dadebertolino/stazione-meteo-lora/hardware/nodo-bme280/nodo-bme280-bom-jlcpcb.csv

Comment | Designator | Footprint | LCSC Part #
10µF 25V X5R 0805 | C1 | C_0805_2012Metric_Pad1.18x1.45mm_HandSolder | C15850
100nF 50V X7R 0805 | C2,C3 | C_0805_2012Metric_Pad1.18x1.45mm_HandSolder | C49678
DMG2305UX-7 | Q1 | SOT-23_Handsoldering | C150470
10k 1% 0805 | R1,R2 | R_0805_2012Metric_Pad1.20x1.40mm_HandSolder | C17414
