dadebertolino/stazione-meteo-lora/hardware/ricevitore/ricevitore-bom-jlcpcb.csv

Comment | Designator | Footprint | LCSC Part #
1µF 50V X7R 0805 | C1 | C_0805_2012Metric_Pad1.18x1.45mm_HandSolder | C28323
10µF 25V X5R 0805 | C2 | C_0805_2012Metric_Pad1.18x1.45mm_HandSolder | C15850
100nF 50V X7R 0805 | C3,C4,C5 | C_0805_2012Metric_Pad1.18x1.45mm_HandSolder | C49678
LED verde 0805 KT-0805G | D1 | LED_0805_2012Metric_Pad1.15x1.40mm_HandSolder | C2297
LED giallo 0805 KT-0805Y | D2 | LED_0805_2012Metric_Pad1.15x1.40mm_HandSolder | C2296
10k 1% 0805 | R3 | R_0805_2012Metric_Pad1.20x1.40mm_HandSolder | C17414
1k 1% 0805 | R4,R5 | R_0805_2012Metric_Pad1.20x1.40mm_HandSolder | C17513
USBLC6-2SC6 | U2 | SOT-23-6 | C7519
AP2112K-3.3TRG1 | U3 | SOT-23-5 | C51118
CH340C | U4 | SOIC-16_3.9x9.9mm_P1.27mm | C84681
