dadebertolino/stazione-meteo-lora/hardware/nodo-bme280/nodo-bme280-schema.pdf

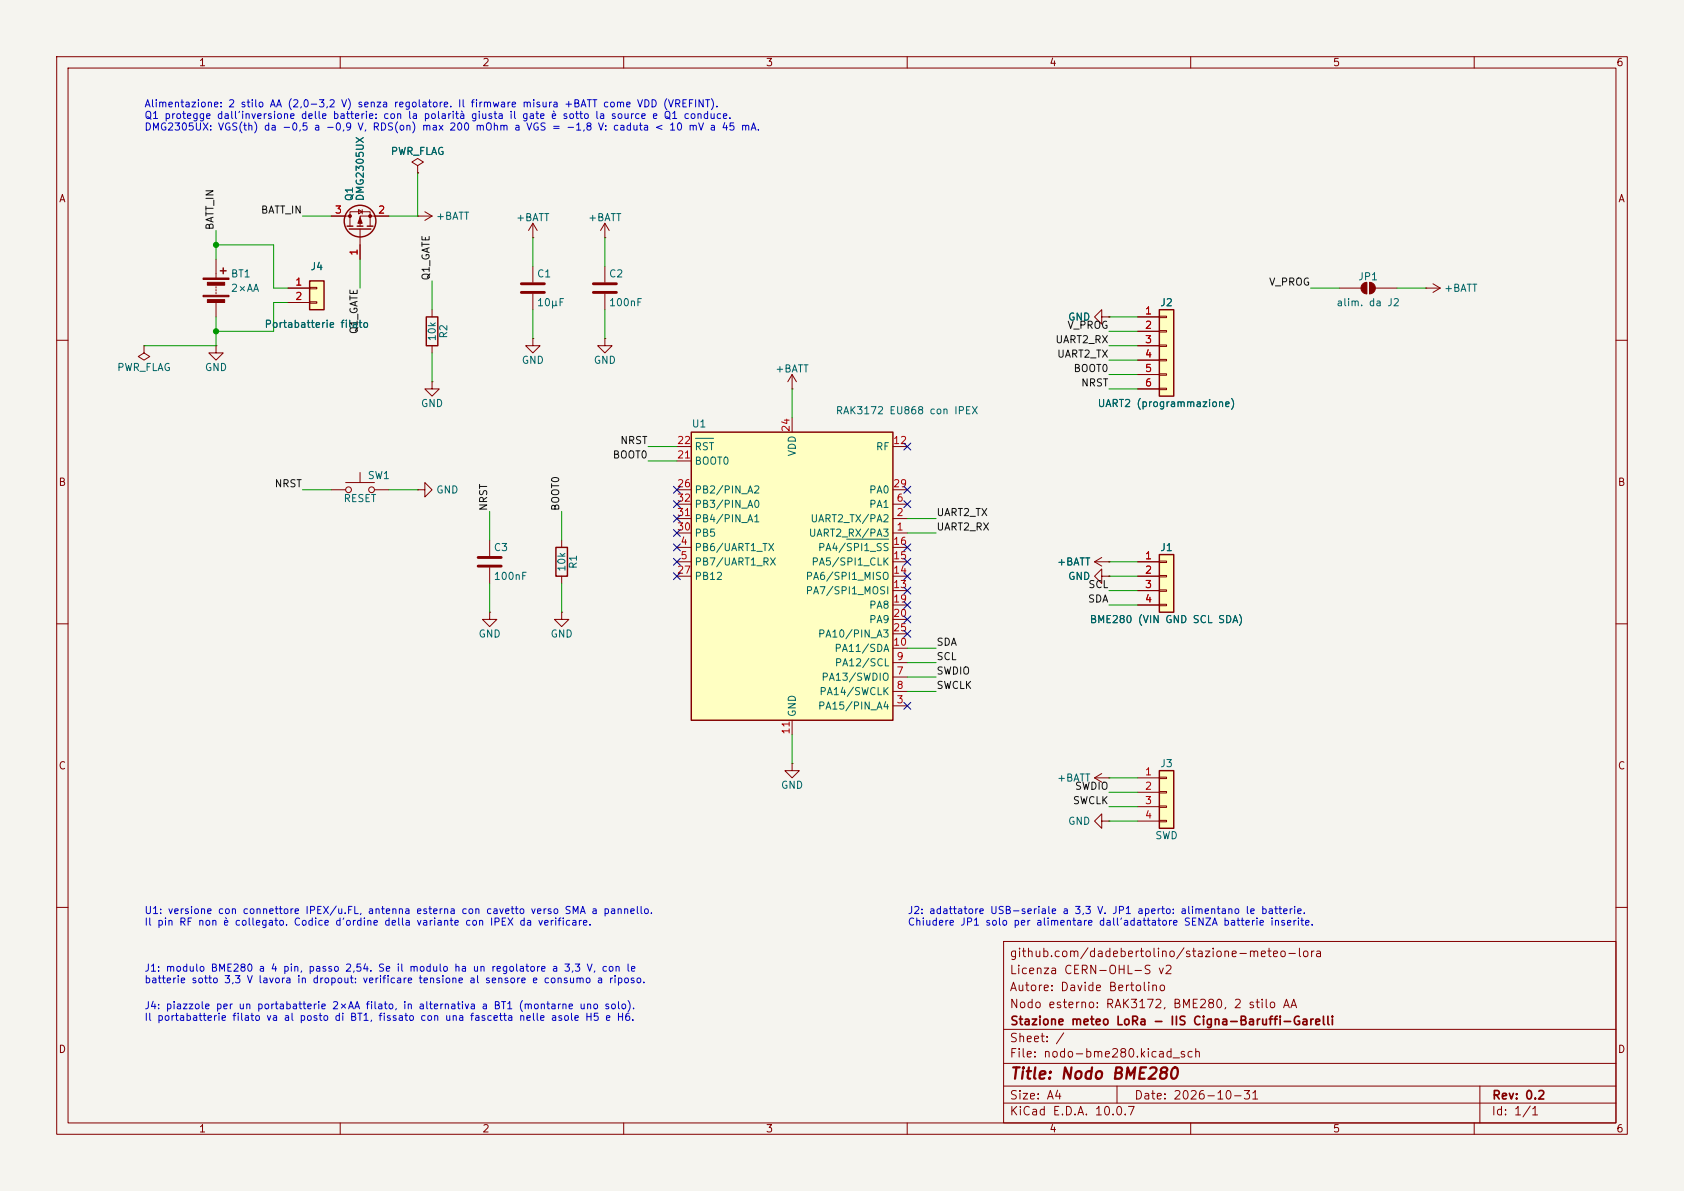
[picture p1: page 1]

Alimentazione: 2 stilo AA (2,0-3,2 V) senza regolatore. Il firmware misura +BATT come VDD (VREFINT). Q1 protegge dall'inversione delle batterie: con la polarità giusta il gate è sotto la source e Q1 conduce. DMG2305UX: VGS(th) da -0,5 a -0,9 V, RDS(on) max 200 mOhm a VGS = -1,8 V: caduta < 10 mV a 45 mA. J4 Portabatterie filato 1

J1 BME280 (VIN GND SCL SDA) +BATT C2

J1 BME280 (VIN GND SCL SDA) 1

Il portabatterie filato va al posto di BT1, fissato con una fascetta nelle asole H5 e H6. J1: modulo BME280 a 4 pin, passo 2,54. Se il modulo ha un regolatore a 3,3 V, con le batterie sotto 3,3 V lavora in dropout: verificare tensione al sensore e consumo a riposo. U1: versione con connettore IPEX/u.FL, antenna esterna con cavetto verso SMA a pannello.

github.com/dadebertolino/stazione-meteo-lora
Licenza CERN-OHL-S v2
Autore: Davide Bertolino
Nodo esterno: RAK3172, BME280, 2 stilo AA
Stazione meteo LoRa - IIS Cigna-Baruffi-Garelli
Sheet: /
File: nodo-bme280.kicad_sch
Title: Nodo BME280

J4: piazzole per un portabatterie 2×AA filato, in alternativa a BT1 (montarne uno solo).

Size: A4 | Rev: 0.2
KiCad E.D.A. 10.0.7 | Id: 1/1
