dadebertolino/stazione-meteo-lora/hardware/ricevitore/ricevitore-schema.pdf

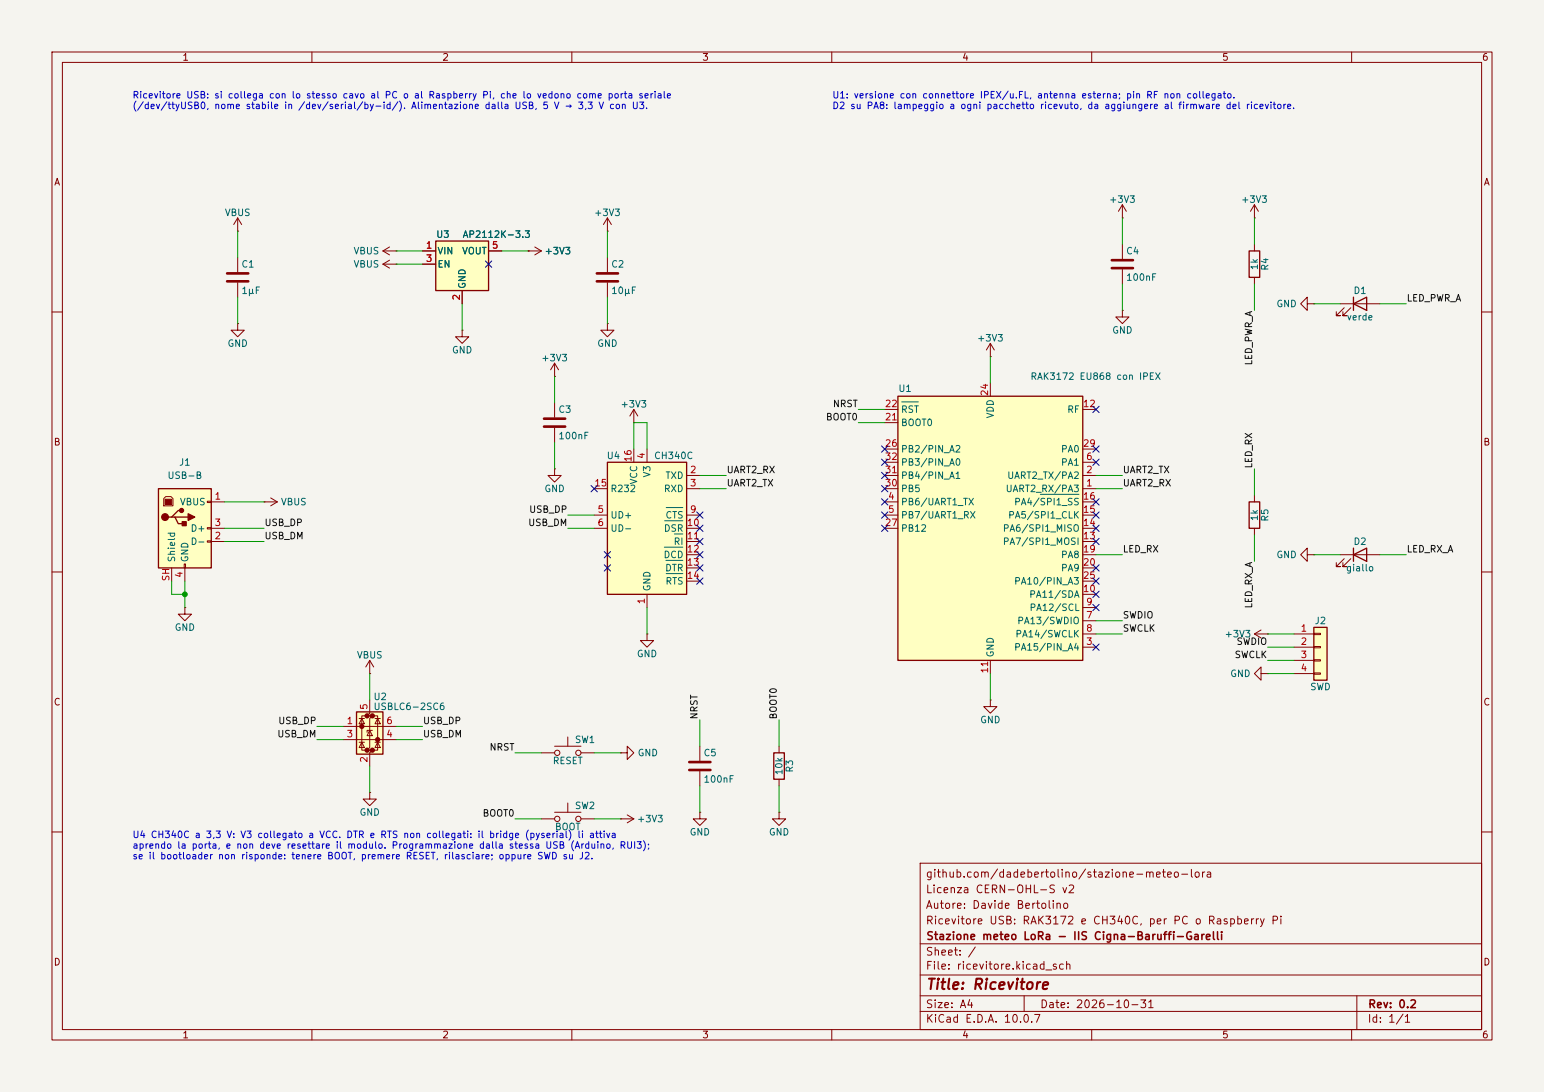
[picture p2: page 1]

Ricevitore USB: si collega con lo stesso cavo al PC o al Raspberry Pi, che lo vedono come porta seriale
(/dev/ttyUSB0, nome stabile in /dev/serial/by-id/). Alimentazione dalla USB, 5 V → 3,3 V con U3. +3V3 U3 AP2112K-3.3

U1: versione con connettore IPEX/u.FL, antenna esterna; pin RF non collegato. D2 su PA8: lampeggio a ogni pacchetto ricevuto, da aggiungere al firmware del ricevitore.

4 UD+ 5 UD- 6 CTS 9 DSR 10 RI 11 DCD 12 DTR 13 RTS 14 R232 15 VCC U4 16CH340C

U4 CH340C a 3,3 V: V3 collegato a VCC. DTR e RTS non collegati: il bridge (pyserial) li attiva
aprendo la porta, e non deve resettare il modulo. Programmazione dalla stessa USB (Arduino, RUI3); se il bootloader non risponde: tenere BOOT, premere RESET, rilasciare; oppure SWD su J2.

github.com/dadebertolino/stazione-meteo-lora
Licenza CERN-OHL-S v2
Autore: Davide Bertolino
Ricevitore USB: RAK3172 e CH340C, per PC o Raspberry Pi
Stazione meteo LoRa - IIS Cigna-Baruffi-Garelli
Sheet: /
File: ricevitore.kicad_sch
Title: Ricevitore

Size: A4 | Rev: 0.2
KiCad E.D.A. 10.0.7 | Id: 1/1
