dadebertolino/stazione-meteo-lora/hardware/nodo-bme280/nodo-bme280.kicad_pcb

## KiCad design hardware/nodo-bme280/nodo-bme280.kicad_pcb (2026-11-05)

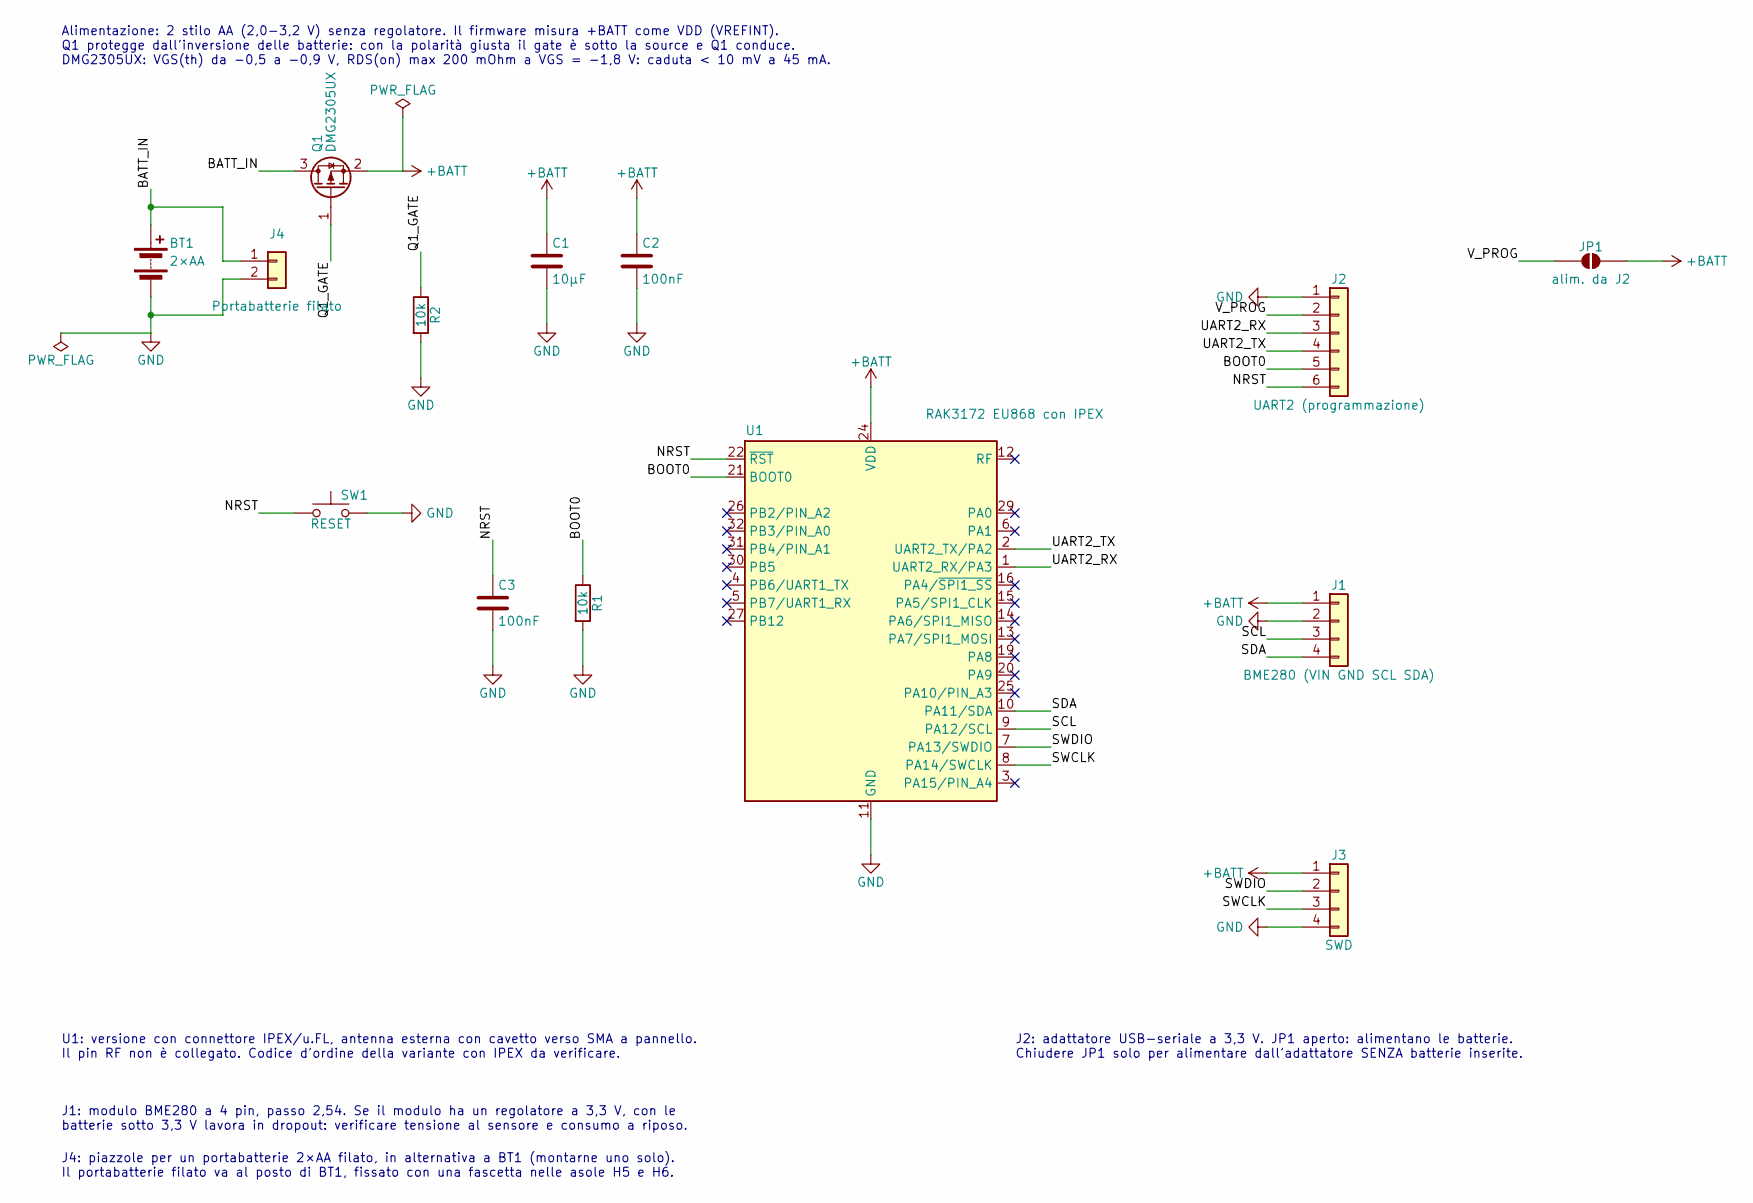
[picture p3: schematic nodo-bme280.kicad_sch, Nodo BME280]

Parts:
BT1: 2×AA; BatteryHolder_Keystone_2462_2xAA
C1: 10µF; C_0805_2012Metric_Pad1.18x1.45mm_HandSolder
C2, C3: 100nF; C_0805_2012Metric_Pad1.18x1.45mm_HandSolder
J1: BME280 (VIN GND SCL SDA); PinSocket_1x04_P2.54mm_Vertical
J2: UART2 (programmazione); PinHeader_1x06_P2.54mm_Vertical
J3: SWD; PinHeader_1x04_P2.54mm_Vertical
J4: Portabatterie filato; SolderWire-0.25sqmm_1x02_P4.2mm_D0.65mm_OD1.7mm_Relief
JP1: alim. da J2; SolderJumper-2_P1.3mm_Open_RoundedPad1.0x1.5mm
Q1: DMG2305UX; SOT-23_Handsoldering
R1, R2: 10k; R_0805_2012Metric_Pad1.20x1.40mm_HandSolder
SW1: RESET; SW_PUSH_6mm
U1: RAK3172 EU868 con IPEX; RAK3172

Connections:
+BATT: C1.1, C2.1, J1.1, J3.1, JP1.2 (B), Q1.2 (S), U1.24 (VDD)
/BATT_IN: BT1.1 (+), J4.1, Q1.3 (D)
/BOOT0: J2.5, R1.1, U1.21 (BOOT0)
/NRST: C3.1, J2.6, SW1.1, U1.22 (~RST)
/Q1_GATE: Q1.1 (G), R2.1
/SCL: J1.3, U1.9 (PA12/SCL)
/SDA: J1.4, U1.10 (PA11/SDA)
/SWCLK: J3.3, U1.8 (PA14/SWCLK)
/SWDIO: J3.2, U1.7 (PA13/SWDIO)
/UART2_RX: J2.3, U1.1 (UART2_RX/PA3)
/UART2_TX: J2.4, U1.2 (UART2_TX/PA2)
/V_PROG: J2.2, JP1.1 (A)
GND: BT1.2 (-), C1.2, C2.2, C3.2, J1.2, J2.1, J3.4, J4.2, R1.2, R2.2, SW1.2, U1.11 (GND), U1.17 (GND), U1.18 (GND), U1.23 (GND), U1.28 (GND)

Notes on the sheet:
J4: piazzole per un portabatterie 2×AA filato, in alternativa a BT1 (montarne uno solo). Il portabatterie filato va al posto di BT1, fissato con una fascetta nelle asole H5 e H6.
Alimentazione: 2 stilo AA (2,0-3,2 V) senza regolatore. Il firmware misura +BATT come VDD (VREFINT). Q1 protegge dall'inversione delle batterie: con la polarità giusta il gate è sotto la source e Q1 conduce. DMG2305UX: VGS(th) da -0,5 a -0,9 V, RDS(on) max 200 mOhm a VGS = -1,8 V: caduta < 10 mV a 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
U1: versione con connettore IPEX/u.FL, antenna esterna con cavetto verso SMA a pannello. Il pin RF non è collegato. Codice d'ordine della variante con IPEX da verificare.
J1: modulo BME280 a 4 pin, passo 2,54. Se il modulo ha un regolatore a 3,3 V, con le batterie sotto 3,3 V lavora in dropout: verificare tensione al sensore e consumo a riposo.
J2: adattatore USB-seriale a 3,3 V. JP1 aperto: alimentano le batterie. Chiudere JP1 solo per alimentare dall'adattatore SENZA batterie inserite.

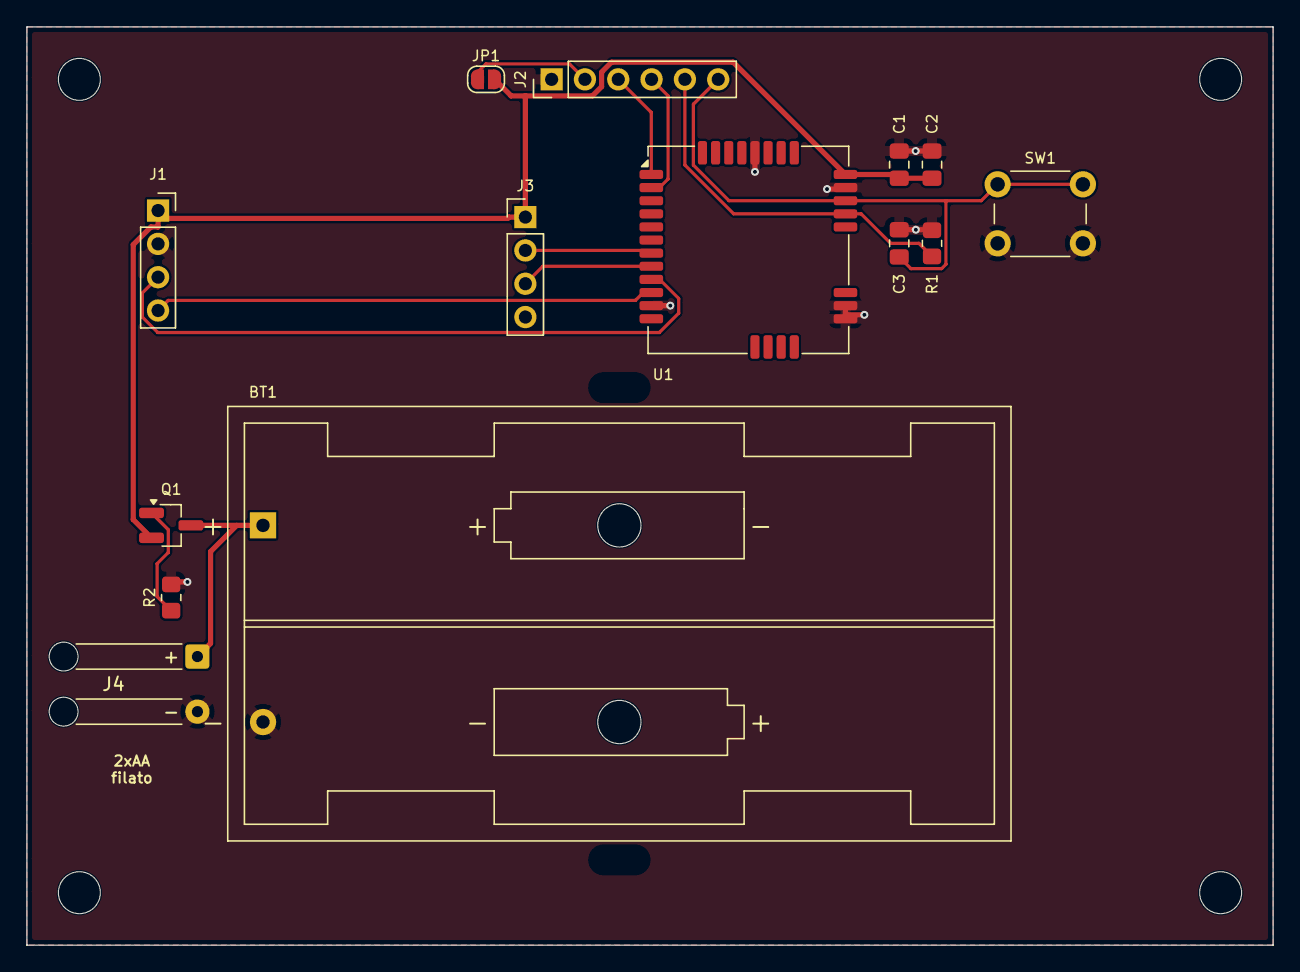
[picture p4: board nodo-bme280.kicad_pcb from above]

Board: 2 copper layers, 95.0 x 70.0 mm, 20 parts (0 on the bottom side), 13 nets.

Other parts of the board:
H1, H2, H3, H4: M3; MountingHole_3.2mm_M3
H5, H6: Asola fascetta; Asola_fascetta_4x1.6mm
