dadebertolino/stazione-meteo-lora/hardware/ricevitore/ricevitore.kicad_pcb

## KiCad design hardware/ricevitore/ricevitore.kicad_pcb (2026-11-05)

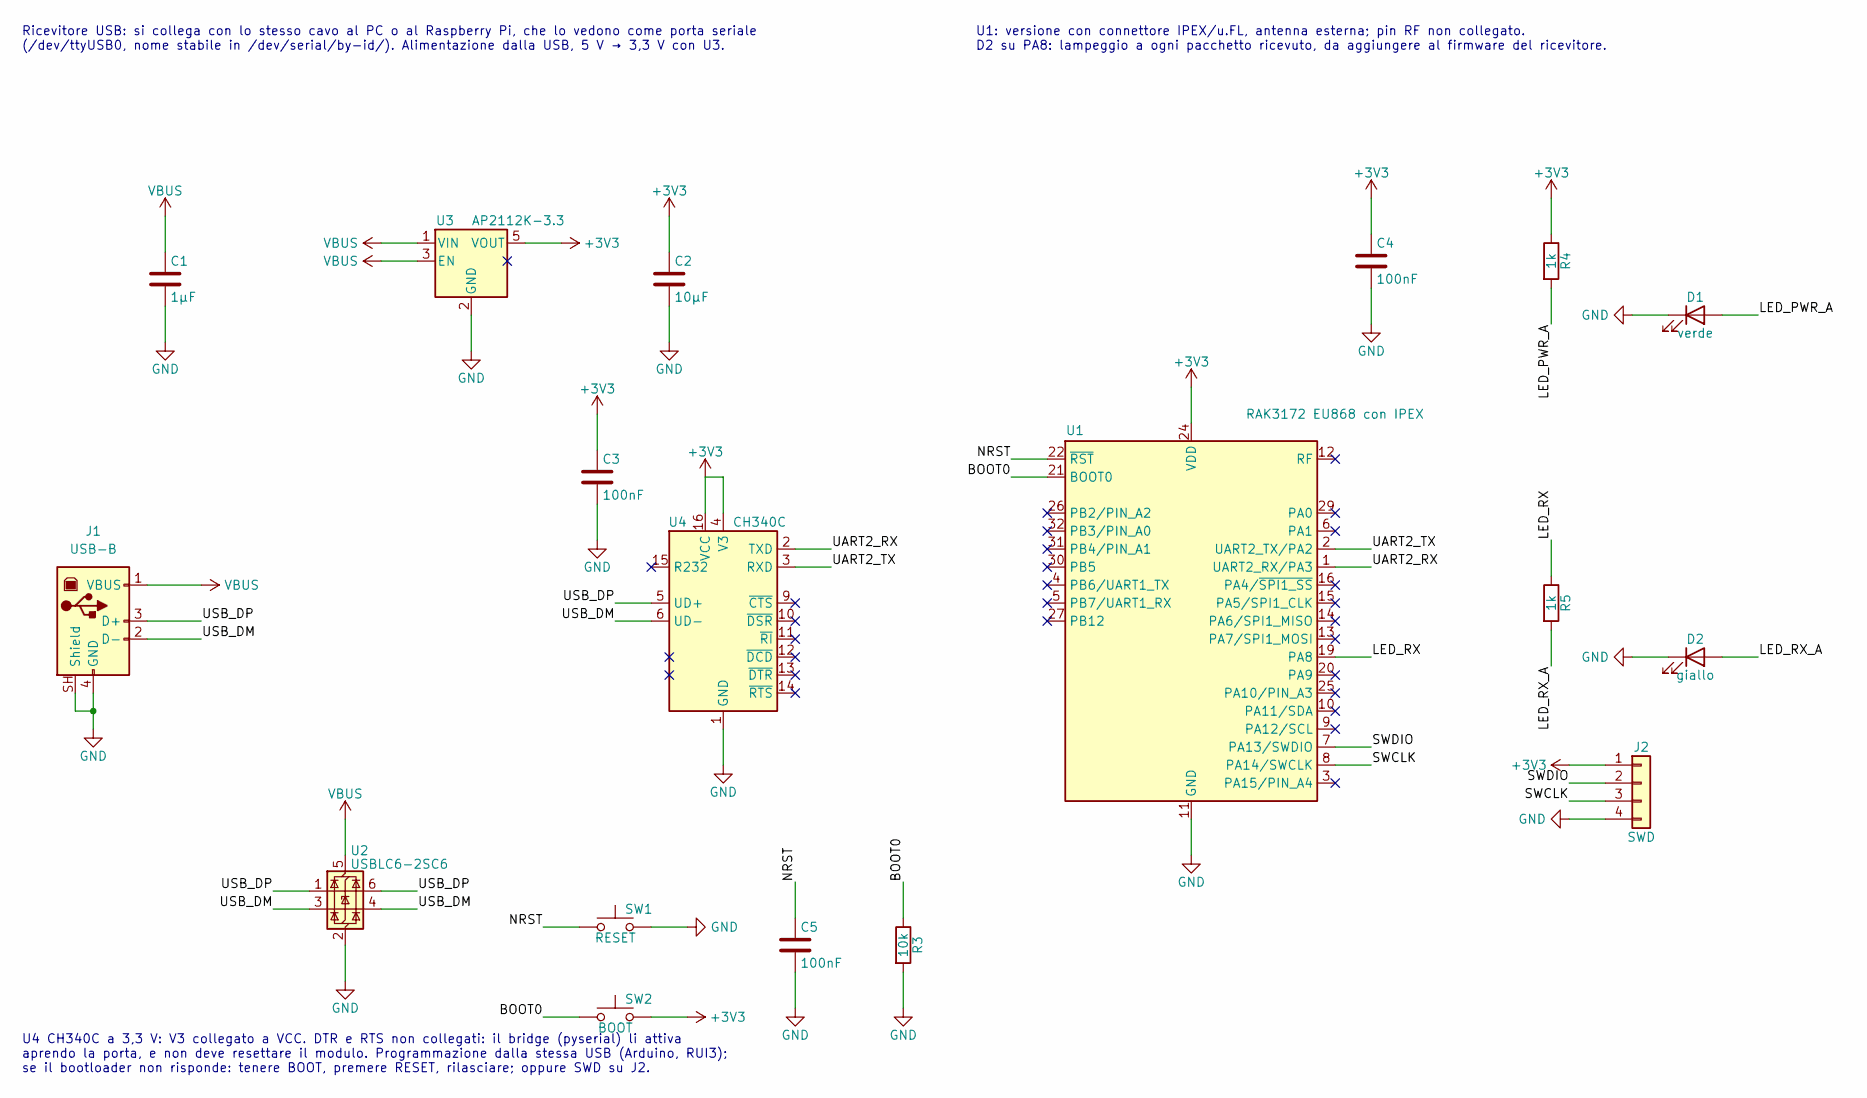
[picture p5: schematic ricevitore.kicad_sch]

Parts:
C1: 1µF; C_0805_2012Metric_Pad1.18x1.45mm_HandSolder
C2: 10µF; C_0805_2012Metric_Pad1.18x1.45mm_HandSolder
C3, C4, C5: 100nF; C_0805_2012Metric_Pad1.18x1.45mm_HandSolder
D1: verde; LED_0805_2012Metric_Pad1.15x1.40mm_HandSolder
D2: giallo; LED_0805_2012Metric_Pad1.15x1.40mm_HandSolder
J1: USB-B; USB_B_Jing_921-111A1010D10200_Horizontal
J2: SWD; PinHeader_1x04_P2.54mm_Vertical
R3: 10k; R_0805_2012Metric_Pad1.20x1.40mm_HandSolder
R4, R5: 1k; R_0805_2012Metric_Pad1.20x1.40mm_HandSolder
SW1: RESET; SW_PUSH_6mm
SW2: BOOT; SW_PUSH_6mm
U1: RAK3172 EU868 con IPEX; RAK3172
U2: USBLC6-2SC6; SOT-23-6
U3: AP2112K-3.3; SOT-23-5
U4: CH340C; SOIC-16_3.9x9.9mm_P1.27mm

Connections:
+3V3: C2.1, C3.1, C4.1, J2.1, R4.1, SW2.2, U1.24 (VDD), U3.5 (VOUT), U4.4 (V3), U4.16 (VCC)
/BOOT0: R3.1, SW2.1, U1.21 (BOOT0)
/LED_PWR_A: D1.2 (A), R4.2
/LED_RX: R5.1, U1.19 (PA8)
/LED_RX_A: D2.2 (A), R5.2
/NRST: C5.1, SW1.1, U1.22 (~RST)
/SWCLK: J2.3, U1.8 (PA14/SWCLK)
/SWDIO: J2.2, U1.7 (PA13/SWDIO)
/UART2_RX: U1.1 (UART2_RX/PA3), U4.2 (TXD)
/UART2_TX: U1.2 (UART2_TX/PA2), U4.3 (RXD)
/USB_DM: J1.2 (D-), U2.3 (I/O2), U2.4 (I/O2), U4.6 (UD-)
/USB_DP: J1.3 (D+), U2.1 (I/O1), U2.6 (I/O1), U4.5 (UD+)
GND: C1.2, C2.2, C3.2, C4.2, C5.2, D1.1 (K), D2.1 (K), J1.4 (GND), J1.SH (Shield), J2.4, R3.2, SW1.2, U1.11 (GND), U1.17 (GND), U1.18 (GND), U1.23 (GND), U1.28 (GND), U2.2 (GND), U3.2 (GND), U4.1 (GND)
VBUS: C1.1, J1.1 (VBUS), U2.5 (VBUS), U3.1 (VIN), U3.3 (EN)

Notes on the sheet:
Ricevitore USB: si collega con lo stesso cavo al PC o al Raspberry Pi, che lo vedono come porta seriale (/dev/ttyUSB0, nome stabile in /dev/serial/by-id/). Alimentazione dalla USB, 5 V → 3,3 V con U3.
U4 CH340C a 3,3 V: V3 collegato a VCC. DTR e RTS non collegati: il bridge (pyserial) li attiva aprendo la porta, e non deve resettare il modulo. Programmazione dalla stessa USB (Arduino, RUI3); se il bootloader non risponde: tenere BOOT, premere RESET, rilasciare; oppure SWD su J2.
U1: versione con connettore IPEX/u.FL, antenna esterna; pin RF non collegato. D2 su PA8: lampeggio a ogni pacchetto ricevuto, da aggiungere al firmware del ricevitore.

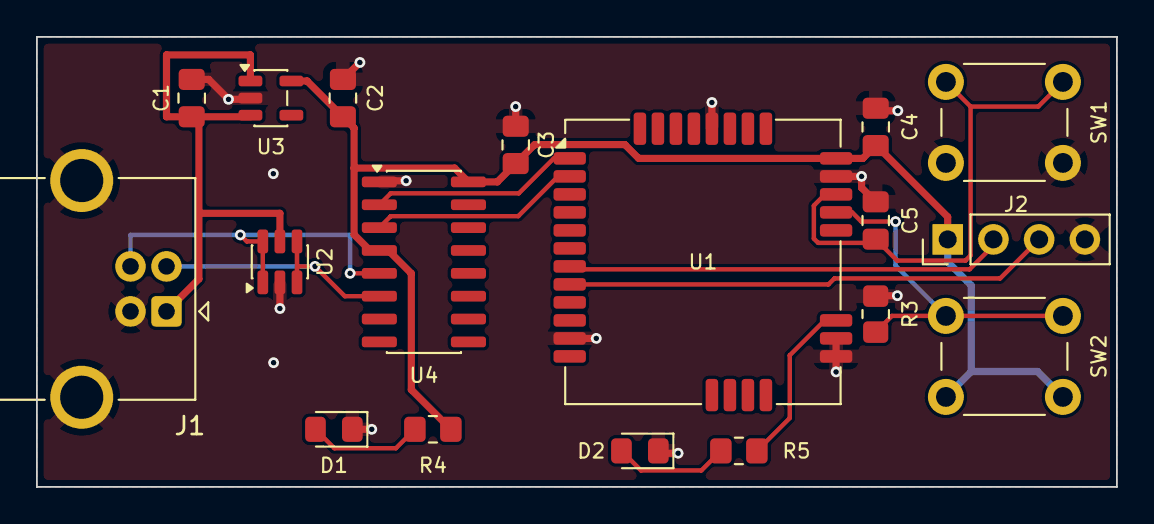
[picture p6: board ricevitore.kicad_pcb from above]

Board: 2 copper layers, 60.0 x 25.0 mm, 18 parts (0 on the bottom side), 14 nets.
