dadebertolino/stazione-meteo-lora/(commit log)

2026-10-16 Link LoRa: sketch del nodo BME280 e del ricevitore P2P sotto versionamento
    Sketch Arduino RUI3 per moduli RAK3172 e README con collegamenti,
    parametri radio, formato dei pacchetti, uscita CSV e punti aperti.
    Il README principale elenca il nuovo strumento. Esclusi da git i
    worktree temporanei di Claude Code.
2026-10-16 Link LoRa: frequenza P2P a 868,1 MHz su nodo e ricevitore
    A 868,000 MHz con banda 125 kHz il segnale sconfinava sotto 868,0 MHz,
    nella banda con duty cycle 0,1 %, superato con l'intervallo di prova a
    30 s. A 868,1 MHz resta tutto nella sottobanda 868,0-868,6 MHz (1 %).
    README: limiti di banda, duty cycle per intervallo, nota su ERP.
2026-10-16 Link LoRa: il nodo reinizializza il BME280 quando la lettura fallisce
    Prima, se il sensore smetteva di rispondere dopo l'avvio, l'indirizzo
    restava impostato e l'inizializzazione non veniva più ritentata.
    Ora una lettura fallita azzera l'indirizzo e il sensore viene
    reinizializzato e riletto nello stesso ciclo.
    bmeRead scarta anche la misura se la lettura dello stato fallisce
    (prima restava non inizializzato), se la conversione non termina entro
    100 ms o se i registri dati contengono ancora i valori di reset.
    [nodo_bme280.ino]
2026-10-16 Link LoRa: il nodo trasmette anche con il sensore guasto
    Se il BME280 non risponde il nodo invia comunque il pacchetto da 10 byte
    con i valori riservati "non disponibile" (T = 0x8000, UR = P = 0xFFFF)
    e la tensione. Il ricevitore li stampa come campi vuoti nel CSV e
    aggiunge una riga di commento: un sensore guasto non si confonde più
    con un nodo spento.
    DBG vuota diventa un'istruzione vuota, così resta valida anche in un
    if/else con DEBUG 0.
2026-10-16 Link LoRa: soglia di tensione alta del nodo a 3600 mV
    VBAT_MAX_MV era 3700 mV, sopra il massimo di alimentazione del RAK3172
    (3,6 V): fra 3600 e 3700 mV l'autodiagnosi dava "OK". Il messaggio di
    errore ora stampa la costante invece di un valore scritto a mano.
    README: soglie dell'autodiagnosi.
    [nodo_bme280.ino]
2026-10-16 Link LoRa: firmware 1.0 di nodo e ricevitore, registratore e prove al banco
    Formato dei pacchetti v1 (BME280 15 byte, SHT45 13 byte, ~46 ms in aria):
    versione e ID nodo, contatore con 0 riservato al primo pacchetto dopo un
    riavvio, tipo di nodo e causa del reset, tensione a riposo e durante la
    trasmissione precedente, CRC-16/CCITT-FALSE.
    Nodo: watchdog a 8 s con sleep a tratti contati su millis(), ritardo
    casuale ±10 % sull'intervallo, sblocco del bus I2C, controllo di
    plausibilità delle misure, soglie di tensione per 2 AA alcaline,
    intervallo minimo verificato in compilazione, nessun riavvio a ciclo se il
    passaggio a P2P fallisce, macro DEBUG rinominata NODE_DEBUG.
    Ricevitore: scarta i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
    [nodo_bme280.ino, registra.py, ricevitore_p2p.ino]
2026-10-25 Link LoRa: nodo 1.1 e ricevitore 1.2
    Il controllo della banda nell'autodiagnosi confronta i kHz: pbw.get() di
    RUI3 4.3.0 restituisce l'indice (0 = 125 kHz) e la banda veniva
    "corretta" a ogni avvio. Il ricevitore stampa un messaggio di benvenuto
    e aspetta 30 s prima di partire. Autore e versione nell'intestazione di
    entrambi gli sketch.
    README: confermato sulla scheda il doppio richiamo della callback sugli
    errori CRC (11 pacchetti estranei in circa 2 ore e mezza, tutti scartati
    senza duplicati); componenti bridge e plugin in struttura.
    [nodo_bme280.ino, ricevitore_p2p.ino]
2026-10-25 Repository pubblico: bridge, hardware, licenze
    Il progetto esce dal repository privato della stazione con la storia dei
    suoi commit. Si aggiungono la struttura del bridge per il Raspberry, la
    cartella degli schemi, le licenze (software GPL v2 o successive,
    hardware CERN-OHL-S v2) e il .gitignore. Il README perde i riferimenti
    alla parte privata e rimanda al plugin WordPress, che ha un repository
    suo.
2026-10-25 Bridge 0.1: lettura della seriale, coda SQLite e invio al sito
    Ogni riga di dati del ricevitore entra in una coda SQLite con l'ora di
    arrivo in UTC; un thread la invia al plugin WordPress in gruppi di 500,
    subito e poi a intervalli, e segna le misure come inviate solo dopo la
    risposta del sito. Sito spento, rete assente o token sbagliato: le
    misure restano in coda. L'indirizzo deve essere https (http solo per
    localhost e .local). Solo libreria standard oltre a pyserial; funziona
    anche con Python 3.9, il file TOML richiede 3.11.
    Provato con il ricevitore vero e un WordPress locale; 21 test senza
    schede, compreso un server HTTP finto.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
2026-10-26 Bridge: script di installazione per il Raspberry e collegamento su GPIO
    installa.sh installa Python e pyserial, crea l'utente di servizio meteo,
    copia il codice in /opt/meteo-bridge, scrive la configurazione (640,
    contiene il token, chiesto senza eco), attiva NTP con server o proxy
    della scuola se servono, prova indirizzo e token con un invio vuoto e
    avvia il servizio. Rilanciato aggiorna il codice e tiene la
    configurazione. Non ancora provato su un Pi.
    Il servizio systemd non può scrivere fuori da /var/lib/meteo-bridge.
    README: installazione, opzioni, e ricevitore sul GPIO (solo il filo TX
    del ricevitore, UART PL011 liberata dal Bluetooth).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
2026-10-27 Nodo 1.2: tensione delle batterie misurata davvero
    api.system.bat.get() di RUI3 4.3.0 sul RAK3172 non legge l'ADC
    (service_battery.c lo fa solo su RAK3172-SiP e basi WisBlock) e
    restituisce sempre 3,0 V: il nodo trasmetteva 3000 mV fissi. Ora
    readVbat() misura il riferimento interno VREFINT a 12 bit (media di 4
    conversioni, la prima scartata) e lo confronta con la taratura di
    fabbrica VREFINT_CAL: senza regolatore la tensione di alimentazione è
    quella delle batterie. Lettura fallita = valore non disponibile.
    Formato dei pacchetti invariato: ricevitore, bridge e plugin restano.
    Prove al banco: niente più avviso FW_VERSION ridefinito. README:
    correzione sulla misura delle batterie, confront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
2026-10-27 Hardware: progetti KiCad e schema 0.1 del nodo BME280
    Cartelle KiCad 9/10 per il nodo BME280 e il ricevitore, con libreria
    condivisa in hardware/librerie collegata da percorsi relativi.
    Schema del nodo: RAK3172 saldato con IPEX (antenna u.FL), alimentazione
    diretta da 2 x AA su Keystone 2462 con protezione dall'inversione
    (P-MOSFET DMG2305UX sul positivo, RDS(on) <= 200 mOhm a VGS -1,8 V),
    modulo BME280 a 4 pin su J1 (I2C su PA11/PA12), programmazione UART2
    con BOOT0 e NRST su J2 (JP1 per alimentare dall'adattatore senza
    batterie), SWD su J3, reset e pull-down di BOOT0. Passivi 0805 con
    piazzole HandSolder, pulsante THT 6 mm, SOT-23 Handsoldering. ERC di
    KiCad 10.0.7: nessuna violazione; ne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
    [nodo-bme280.kicad_sch, ricevitore.kicad_sch]
2026-10-27 Hardware: schema 0.1 del ricevitore USB
    Chiavetta da collegare con lo stesso cavo al PC o al Raspberry Pi:
    USB-C solo USB 2.0 (5,1 k su CC), USBLC6-2SC6 sulle linee dati,
    AP2112K-3.3, CH340C alimentato a 3,3 V (V3 su VCC) per avere la UART ai
    livelli del RAK3172, RAK3172 con IPEX su UART2. DTR e RTS non
    collegati: pyserial li attiva aprendo la porta e il bridge non deve
    resettare il modulo; pulsanti RESET e BOOT, pull-down su BOOT0, SWD per
    il recupero. LED di alimentazione e LED su PA8 per i pacchetti ricevuti.
    ERC di KiCad 10.0.7: una sola segnalazione, V3 del CH340C (uscita di
    alimentazione nel simbolo) sulla rete di VOUT di U3, esclusa con la
    motivazione nel .kicad_pro; netlist controll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
    [ricevitore.kicad_sch]
2026-10-28 Hardware: circuito stampato 0.1 del ricevitore USB
    Scheda 60 x 25 mm a 2 strati, componenti tutti sopra: USB-C a filo del
    bordo, USBLC6 (ruotato perché GND e VBUS escano dai lati liberi) e
    AP2112K, CH340C, RAK3172 al centro, RESET, SWD e BOOT all'estremità.
    Piano GND su entrambi gli strati, quello inferiore quasi intero.
    Classe Alimentazione (GND, VBUS, +3V3) a 0,4 mm: a 0,5 mm le piste non
    uscivano dalle piazzole a passo 0,5 della USB-C. Sbroglio con
    Freerouting 1.9.0 da Specctra; DRC di KiCad 10.0.7 con confronto sullo
    schema: nessun errore, restano due avvisi di serigrafia del guscio USB
    tagliata dal bordo. La regola in ricevitore.kicad_dru accetta un raggio
    solo sul lato superiore per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
    [ricevitore.kicad_pcb]
2026-10-28 Hardware: circuito stampato 0.1 del nodo BME280
    Scheda 95 x 70 mm per la scatola stagna IP65 da 115 x 90 x 55 mm
    (LeMotech e simili): fori M3 a 4 mm dagli angoli, da spostare sulle
    colonnine quando la scatola è misurata. RAK3172 in alto con J2, J3 e J1
    attorno, portabatterie 2 x AA in basso con Q1 e R2 accanto al positivo.
    Tutte le piste sopra, piano GND intero sotto; stesse regole del
    ricevitore, classe Alimentazione per GND, +BATT e BATT_IN.
    DRC di KiCad 10.0.7 con confronto sullo schema: nessuna violazione.
    README di hardware aggiornato con entrambi i circuiti stampati, la
    scatola e i punti da verificare prima dell'ordine; schema in PDF.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
    [nodo-bme280.kicad_pcb]
2026-10-28 Hardware: Gerber, BOM e CPL per JLCPCB di ricevitore e nodo
    Gerber (rame, mask, serigrafia, pasta superiore, contorno) e foratura
    Excellon in mm generati con KiCad 10.0.7, anche in zip per l'ordine.
    BOM e CPL nel formato del montaggio JLCPCB, solo SMD, con codici LCSC
    controllati: i passanti si saldano a mano. Il RAK3172-8-SM-I è
    esaurito su LCSC, annotato nel README con le rotazioni da verificare
    nell'anteprima e i Gerber del nodo da rifare dopo la misura della
    scatola.
    [nodo-bme280-B_Cu.gbl, nodo-bme280-B_Mask.gbs, nodo-bme280-B_Silkscreen.gbo, nodo-bme280-Edge_Cuts.gm1, nodo-bme280-F_Cu.gtl, nodo-bme280-F_Mask.gts, nodo-bme280-F_Paste.gtp, nodo-bme280-F_Silkscreen.gto]
2026-11-05 Hardware 0.2: ricevitore con USB-B, nodo con portabatterie filato
    Schemi, circuiti stampati, Gerber, BOM e CPL 0.2 del nodo BME280 e del
    ricevitore; impronte USB-B Jing 921-111A1010D10200 e asola per fascetta;
    ordine LCSC per 5+5 schede. Esclusa la cronologia locale di VS Code.
    Claude-Session: https://claude.ai/code/session_01NVC8YWWnTyJzG7fhzcSp5H
    [lcsc-ordine-5+5.csv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]
2026-11-05 Bridge: aggiunta la dipendenza requests
    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
